Perth-Artifactory/Coil-Driver-Kit/eagle/coildriver/Driver3.brd

## EAGLE design eagle/coildriver/Driver3.brd (2011-12-24)

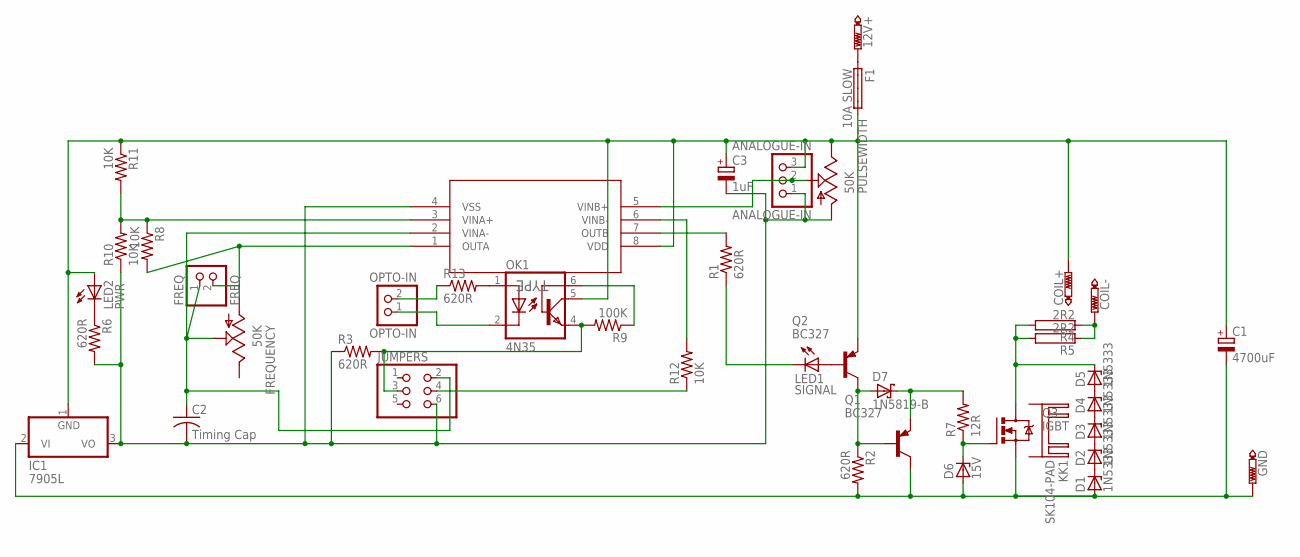
[picture p1: schematic Driver3.sch]

Parts:
12V+: PTR1PAD1-20Y; P1-20Y
ANALOGUE-IN: ANALOGUE-IN; 1X03
C1: 4700uF; E7,5-16
C2: Timing Cap; C050-025X075
C3: 1uF; E5-5
COIL+: PTR1PAD1-20Y; P1-20Y
COIL-: PTR1PAD1-20Y; P1-20Y
D1, D2, D3, D4, D5: 1N5333; C1702-15
D6: 15V; DO34Z7
D7: 1N5819-B; DO41-7.6
F1: 10A SLOW; SHK20L
FREQ: FREQ; 1X02
FREQUENCY: 50K; B25X
GND: PTR1PAD1-20Y; P1-20Y
IC1: 7905L; TO92
JUMPERS: PINHD-2X3; 2X03
KK1: SK104-PAD
LED1: SIGNAL; LED3MM
LED2: PWR; LED3MM
OK1: 4N35; DIL06
OPTO-IN: OPTO-IN; 1X02
PULSEWIDTH: 50K; B25X
Q1, Q2: BC327; TO92
Q3: IGBT; TO220BV
R1, R2, R3, R6, R13: 620R; 0204/7
R4, R5: 2R2; HPS947
R7: 12R; 0204/7
R8, R10, R11, R12: 10K; 0204/7
R9: 100K; 0204/7
U$1: MCP6542-X/P; PDIP8_300MC

Connections:
unnamed: D6.C, Q3.G, R7.1
unnamed: COIL-.TP, R4.1, R5.1
unnamed: D7.A, Q1.2 (B), Q2.3 (C), R2.1
unnamed: ANALOGUE-IN.3, C1.+, C3.+, COIL+.TP, F1.2A, IC1.1 (GND), LED2.A, OK1.5 (COL), PULSEWIDTH.E, Q2.1 (E), R11.1, U$1.8 (VDD)
unnamed: R8.1, R10.2, R11.2, U$1.3 (VINA+)
unnamed: D4.C, D5.A
unnamed: R1.2, U$1.7 (OUTB)
unnamed: C1.-, D1.A, D6.A, GND.TP, IC1.2 (VI), Q1.3 (C), Q3.S, R2.2
unnamed: ANALOGUE-IN.1, C2.2, C3.-, IC1.3 (VO), JUMPERS.6, PULSEWIDTH.A, R3.1, R6.2, R10.1, U$1.4 (VSS)
unnamed: D1.C, D2.A
unnamed: D2.C, D3.A
unnamed: D3.C, D4.A
unnamed: D5.C, Q3.D, R4.2, R5.2
unnamed: 12V+.TP, F1.1A
unnamed: LED1.A, Q2.2 (B)
unnamed: ANALOGUE-IN.2, PULSEWIDTH.S, U$1.5 (VINB+)
unnamed: LED2.K (C), R6.1
unnamed: D7.C, Q1.1 (E), R7.2
unnamed: R12.2, U$1.6 (VINB-)
unnamed: FREQ.2, FREQUENCY.A, R8.2, U$1.1 (OUTA)
unnamed: C2.1, FREQ.1, FREQUENCY.S, JUMPERS.2, U$1.2 (VINA-)
unnamed: JUMPERS.4, R12.1
unnamed: JUMPERS.3, OK1.4 (EMI), R3.2, R9.2
unnamed: OK1.6 (BAS), R9.1
unnamed: OK1.1 (A), R13.2
unnamed: OK1.2 (C), OPTO-IN.1
unnamed: OPTO-IN.2, R13.1
unnamed: LED1.K (C), R1.1

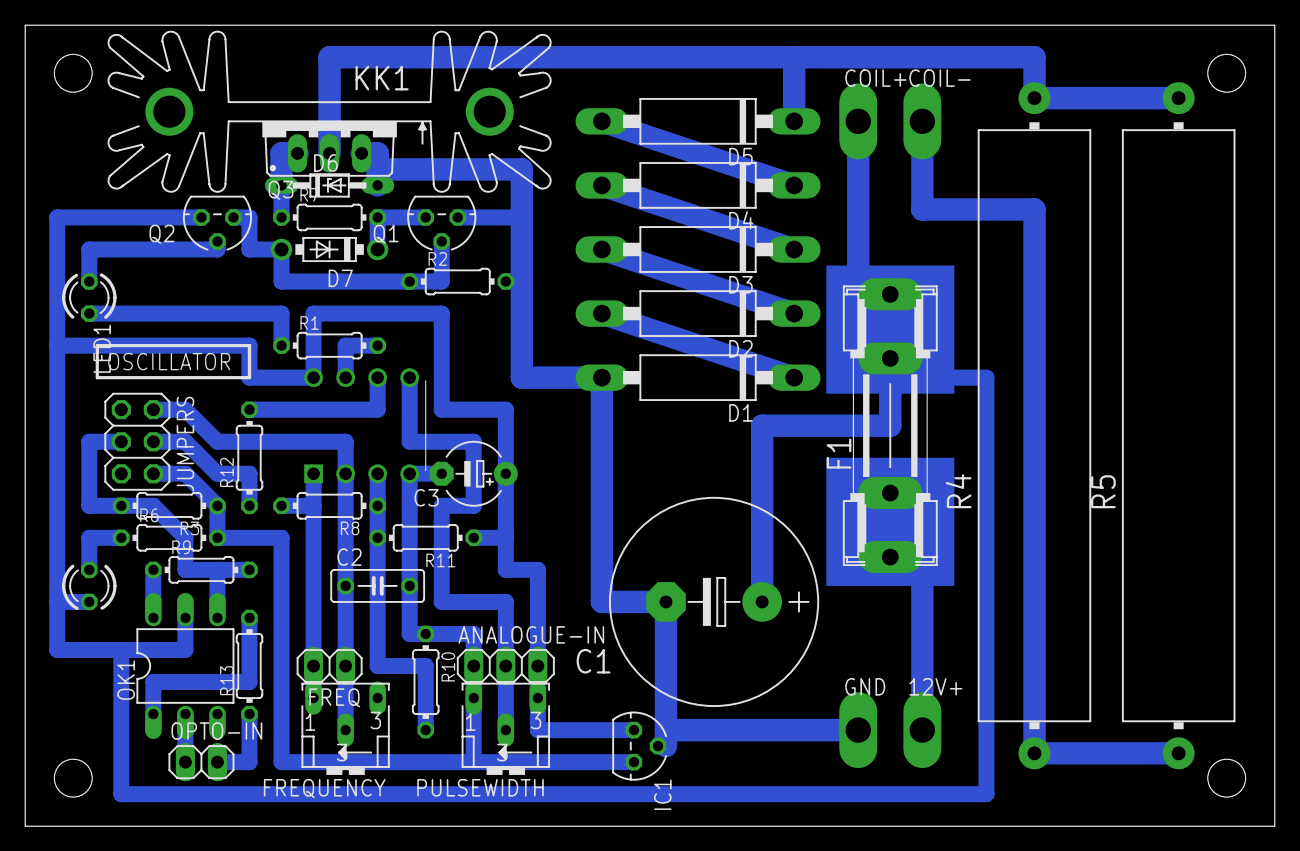
[picture p2: board Driver3.brd from above]

Board: 2 copper layers, 99.1 x 63.5 mm, 43 parts (0 on the bottom side), 28 nets.
