Perth-Artifactory/Coil-Driver-Kit/documentation/instructions/v1.2-instructions.odt

Coil Driver Kit

Version 1.2

For batch 2011-03

Board Errata

- Replace 4k Resistor with 3.9k
- BC556 Transistor replaced by BC337
- BC546 Transistor replaced by BC327
- 5A fuse replaced by 10A fuse (5A is notionally safer, but tends to blow unnecessarily)
- Kit is actually licensed under the TAPR NCL not the TAPR OHL We have no objection to others selling a version of this kit, we just prefer that they pick up the phone first and would prefer our names not be on something we would consider sub-standard.

Parts List

Qty | Part Description | Package | Distinguishing Features / Marking
1 | 600v N-Channel IGBT | TO220
1 | Signal Transistor BC327 | TO92 | Bent leads, Marked 'BC 7-25' (Printing Error?)
1 | Signal Transistor BC337 | TO92 | Straight leads, Marked BC337-25
1 | 12R Resistor | | Brown | Red | Black | Gold | Brown
1 | 68R Resistor | | Blue | Grey | Black | Gold | Brown
1 | 220R Resistor | | Red | Red | Black | Black | Brown
1 | 620R Resistor | | Blue | Red | Black | Black | Brown
2 | 1K2 Resistor | | Brown | Red | Black | Brown | Brown
1 | 2K2 Resistor | | Red | Red | Black | Brown | Brown
1 | 3K9 Resistor | | Orange | White | Black | Brown | Brown
2 | 2R2 Power Resistor | Large Ceramic | Large white resistor printed with '10W 2R2J'
1 | 10nF Capacitor | MKT
1 | 63v 1uF Capacitor | Electrolytic
1 | 16v 4700uF Capacitor | Electrolytic
1 | 15v Zener Diode | DO-35 | Slightly longer than 1N4148
5 | 75v Zener Diode | 017AA
1 | Rectifier Diode 1N4148 | DO-35 | Slightly shorter than 15v Zener
1 | 50K Cermet Trimpot
1 | NE555 Timer IC | DIP-8
1 | 4N35 Opto-Isolator | DIP-6
2 | Fuse Clips
1 | 10A Fuse
1 | 2.54mm Shunt
2 | 2x1 2.54mm Pin Header
1 | Red LED | 3mm | Diffused Red Lens
1 | Blue LED | 3mm | Waterclear Lens

Assembly Instructions

Install the components starting with the lowest-profile parts first to aid in keeping things flush when soldering.

You must install the 15v gate protection Zener diode before installing the IGBT to prevent damage from ESD.

Be careful when clipping leads from the resistors as the pads are smaller than they should be and can lift if pulled.

TODO: More Instructions!

Operation Instructions

The coil driver can operate in 2 modes, internal and external oscillator. The internal oscillator is based on a 555 timer using a trim-pot to adjust the output frequency. In external oscillator mode the board will take a 5v TTL signal through a 4N35 opto-isolator.
