Perth-Artifactory/Coil-Driver-Kit/(commit log)

2011-07-09 Removed superfluous folders inherited from my dropbox
    [Driver3.brd, Driver3.sch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]
2011-07-15 Added documentation
    [coildriver-kit-costing.ods]
2011-08-22 Implemented comparator based oscillator in schematic, still needs laying out
    [Driver3.brd, Driver3.sch, coildriver-kit-costing.ods]
2011-08-27 Started migration to v2.0 driver using comparator oscillator
    [Driver3.brd, Driver3.sch]
2011-08-30 wired oscillator, needs signal LED and minimum resistor on frequency pot.
    [Driver3.brd, Driver3.sch]
2011-08-30 better break-in for signal and oscillator select
    [Driver3.brd, Driver3.sch]
2011-08-31 one break-in/out point for all signals, corrected voltage rail errors in comparator
    [Driver3.brd, Driver3.sch]
2011-08-31 different headers, added opto-coupler
    [Driver3.brd, Driver3.sch]
2011-08-31 Wired in signal LED
    [Driver3.brd, Driver3.sch]
2011-08-31 Renamed TTL LED to signal LED
    [Driver3.brd, Driver3.sch]
2011-08-31 Fixed incorrect polarity on signal LED
    [Driver3.brd, Driver3.sch]
2011-08-31 went to town with the layout
    [Driver3.brd, Driver3.sch]
2011-09-01 more layout edits
    [Driver3.brd, Driver3.sch]
2011-09-04 Did some minor layouting and cleanup, layout *should* now be workable for prototyping
    [Driver3.brd]
2011-09-04 jumper correction
    [Driver3.brd, Driver3.sch]
2011-09-04 finished wiring
    [Driver3.brd]
2011-09-04 checked for layout errors, ready to prototype
    [Driver3.brd]
2011-09-04 Board slightly enlarged, all one layer no jumpers.
    [Driver3.brd]
2011-09-05 Rerouted ref bus for oscillator around the bottom of the board and shifted circuit over to allow clearance for mounting holes.
    [Driver3.brd]
2011-09-07 Moved current version from experimental to master
2011-09-07 Minor layouting fixes, improved spacing between potentiometers
    [Driver3.brd]
2011-09-08 Silkscreen cleanup and minor layouting changes, aesthetic only.
    [Driver3.brd]
2011-09-08 Fixed some ERC errors introduced from tweaking the layout
    [Driver3.sch]
2011-09-12 Fixed screw terminal hole spacing, added heatsink mounting holes and general silkscreen cleanup
    [Driver3.brd, Driver3.sch]
2011-09-17 Silkscreen improvements and added heatsink
2011-09-17 IMPORTANT! fix on comparator polarity
    [Driver3.brd, Driver3.sch]
2011-09-17 swapped comp gates and laid out copper, needs cleanup
    [Driver3.brd, Driver3.sch]
2011-09-17 Silkscreen improvements and general cleanup
    [Driver3.brd, Driver3.sch]
2011-09-17 there was an unnecessary kink in a wire! (and other edits)
    [Driver3.brd]
2011-09-19 Minor silkscreen tweaks and layout adjustments.
    [Driver3.brd]
2011-09-25 just a few copper layer overlaps
    [Driver3.brd, Driver3.sch]
2011-09-25 Minor tweaks to silkscreen, generated manufacturing files, ready to send to PCB fabricator.
    [Driver3.brd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]
2011-09-25 Resistors moved to standard pitch, more silkscreen and spacing tweaks
    [Driver3.brd, Driver3.sch]
2011-09-25 last fixes
    [Driver3.brd]
2011-09-25 Generated fresh Gerber files, this revision sent for fabrication.
    [Driver3.brd]
2011-09-26 Remove archaic costing document, doesnt belong in VCS
    [coildriver-kit-costing.ods]
2011-09-27 Couple of fixes to the documentation parts list
2011-10-19 New boards tested, moving to stable
2011-12-24 Yay for Eagle XML format
    [Driver3.brd, Driver3.sch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]
2011-12-24 Silkscreen fixes
    [Driver3.brd, Driver3.sch]
