Perth-Artifactory/Coil-Driver-Kit/(notices)

Notices in the files:
eagle/coildriver/Driver3.brd:
Copyright 2011
